Nicobranas/RoDeP-documentation/README.md

#RoDeP-documentation

The project main documentation available at: https://nicobranas.github.io/RoDeP-documentation/
