Nicobranas/RoDeP-documentation/docs/hardware_starting.md

# Building the robot

## Building order

<p align = justify>The RoDeP build can be separate in 2 parts : the frame and the gripper. The first one has most of the electronics, with the battery and the boards, the second has the gripping system, used for the elevation of the plant. Therefore, both part can be assembled simulteanously, and bind together at a later point of the project.<br/> </p>

## Building the frame

<p align = justify>As previously mentionned, the frame has most of the electronics systems of the robot. You can find the instructions in the next part.
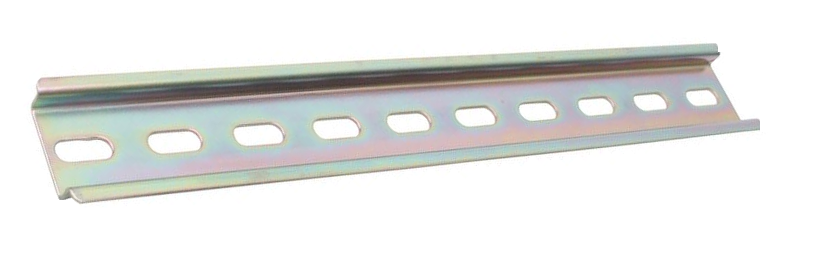
[picture p1: docs/RailDIN files/rail_DIN.png]
Rail DIN

<br/> </p>

## Building the gripper

<p align = justify>The gripper allows the RoDeP to grab the plants, elevate them in order to scan. The instructions are found after the frame.
<br/> </p>
