Nicobranas/RoDeP-documentation/docs/electriccircuit.md

## Electrical diagram

<p align = justify> Here is a diagram representing the principle of the electrical planning.</p>

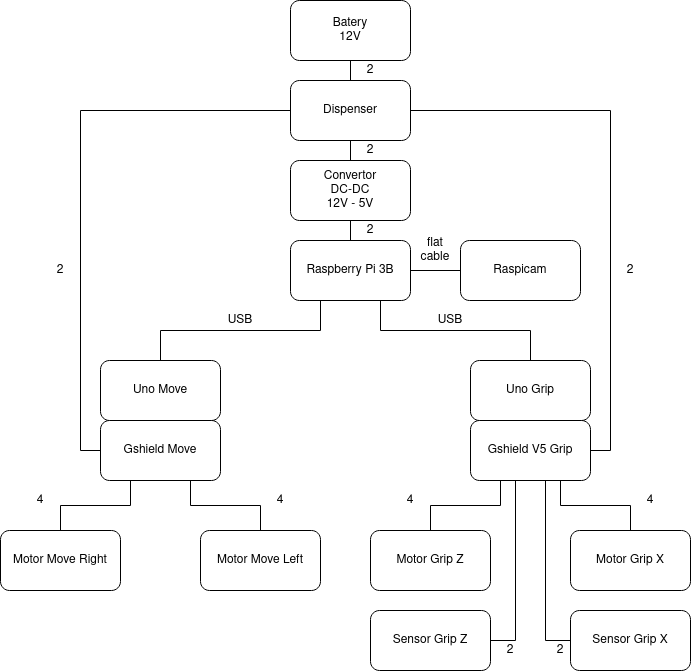
[picture p2: docs/Electronic files/electrical_diagram.png]
Electrical Diagram


## Fritzing document

<p align = justify>This Fritzing document is avaible [here](https://github.com/Nicobranas/RoDeP-documentation/tree/master/docs/Electronic%20files). On this document, we use one driver per motor, but on the real robot we have chosen to use [gShield V5](https://www.adafruit.com/product/1750), which simplify the diagram. We didn't have represent leds and camera on it, please refere to [this guide](http://www.farnell.com/datasheets/1944095.pdf)</p>

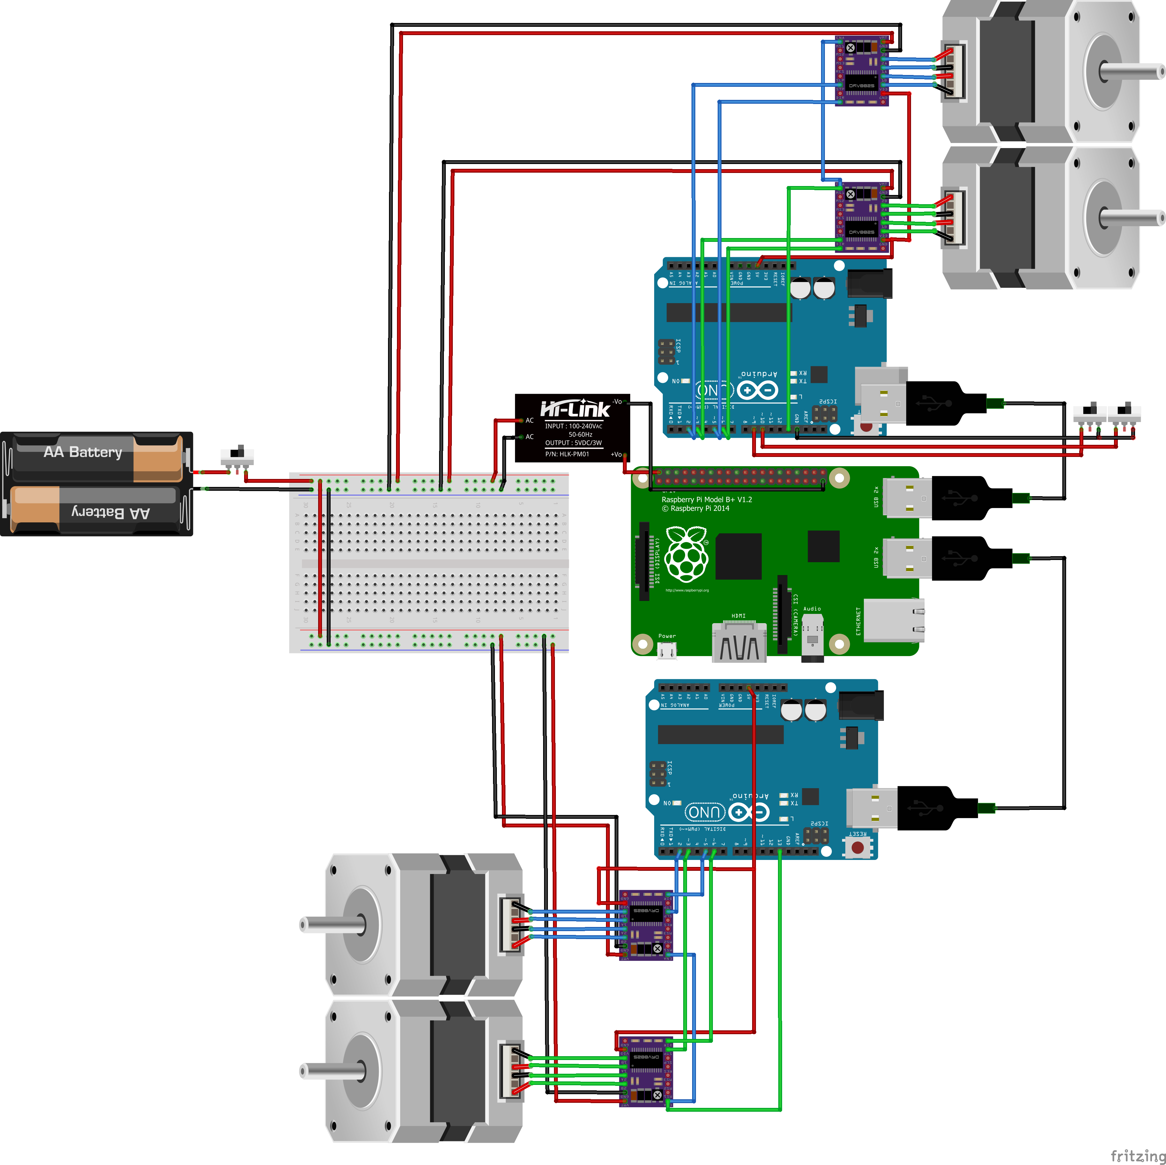
[picture p3: docs/Electronic files/RoDeP-elec.png]
Fritzing


## Steppers motors

<p align = justify>We choose steppers motors for their high accuracy. Useful for helping the line following algorithm and gripper control. Their consumption is bigger than DC motors, as they need power when not in motion, in order to hold their position.</p>
