Nicobranas/RoDeP-documentation/docs/gripp.md

#Gripper components

<p align = justify>On this page, you will find every components you need to assemble everything related to the gripper.
<br/> </p>

## The gripping part
<p align = justify>First of all, the list of the elements found on the gripping part is below :
<br/> </p>
|Number|Component|Specifications|Example|
|----|----|----|----|
|2|linear guide|||
|4|Attaches|length 25 cm||
|1|Gripper motor|Step motor|[Motor](https://www.robotshop.com/eu/fr/rbsoy07-moteur-pas-a-pas-soyo.html)|
|1|belt|length cm||
|2|cogwheel|Diameter cm, teeth||
|2|clamping jaw|||
|4|Rings|||
|4|Rings for securing the opening/closing process|||
|1|limit switch|||
|3|Screw|Reference ||
|2|binding for linear guide|||
|1|binding for worm screw|||
|14|fixing bolt|||
|4|small screw|Reference M4x12||

## Support of the gripper
<p align = justify>The components for the support part is here :
<br/> </p>
|Number|Component|Specifications|Example|
|----|----|----|----|
|4|linear guide|length : 34,5 cm, diameter 4 mm||
|1|Bottom Plate|Custom made|The plan can be found on the Git page of the project|
|1|Top plate|Custom made|The plan can be found on the Git page of the project|
|1|Gripper motor|Step motor|[Motor](https://www.robotshop.com/eu/fr/rbsoy07-moteur-pas-a-pas-soyo.html)|
|1|Worm screw|length : 40 cm, diameter cm||
|10|Clamps|Internal diameter 4 mm||
|38|M4x12 Screw|||
|4|washer|||
|2|Worm screw guide|||
|1|small cogwheel|diameter cm, teeth||
|1|big cogwheel|diameter cm, teeth||
