Nicobranas/RoDeP-documentation/docs/software_starting.md

## Software

<p align = justify> The software part of the robot has been divided in 2 : The tracking part, and the control one. Uploading the code found on Github on your Raspberry should do the trick.<br/></p>

## The tracking part
<p align = justify> The explanation of the code explaining how the RoDeP follows the line will be found here. You will find the design of the playground of the robot, the process of how the robot follows the indication marked on the ground and how the error is calculated.<br/></p>

## The control
<p align = justify> This part contains all the information you need about the control. After a brief explanation of the differents states of the machine, you can also read on how we defined the proportionnal corrector of the robot.<br/></p>
