Nicobranas/RoDeP-documentation/CAO/Support/sup_pi3_verso.jpg

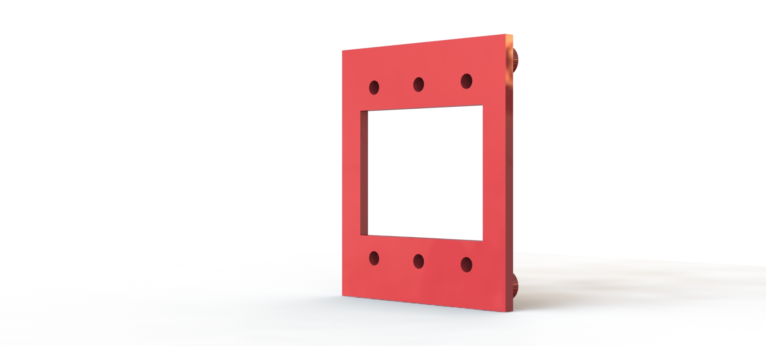
CAO/Support/sup_pi3_verso.jpg
