Nicobranas/RoDeP-documentation/CAO/Support/sup_uno_verso.jpg

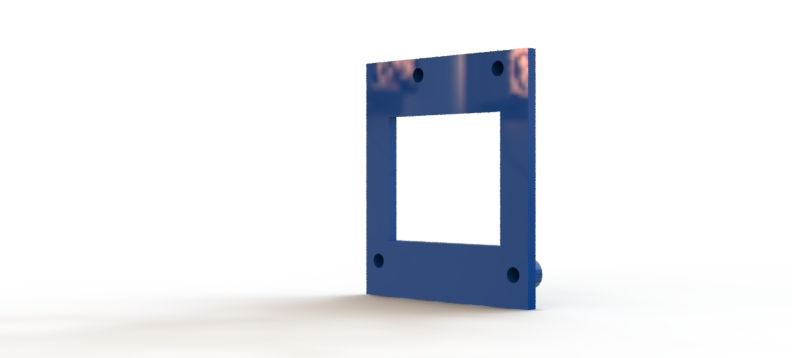
CAO/Support/sup_uno_verso.jpg
