Nicobranas/RoDeP-documentation/site/Electronic files/begin_conception.png

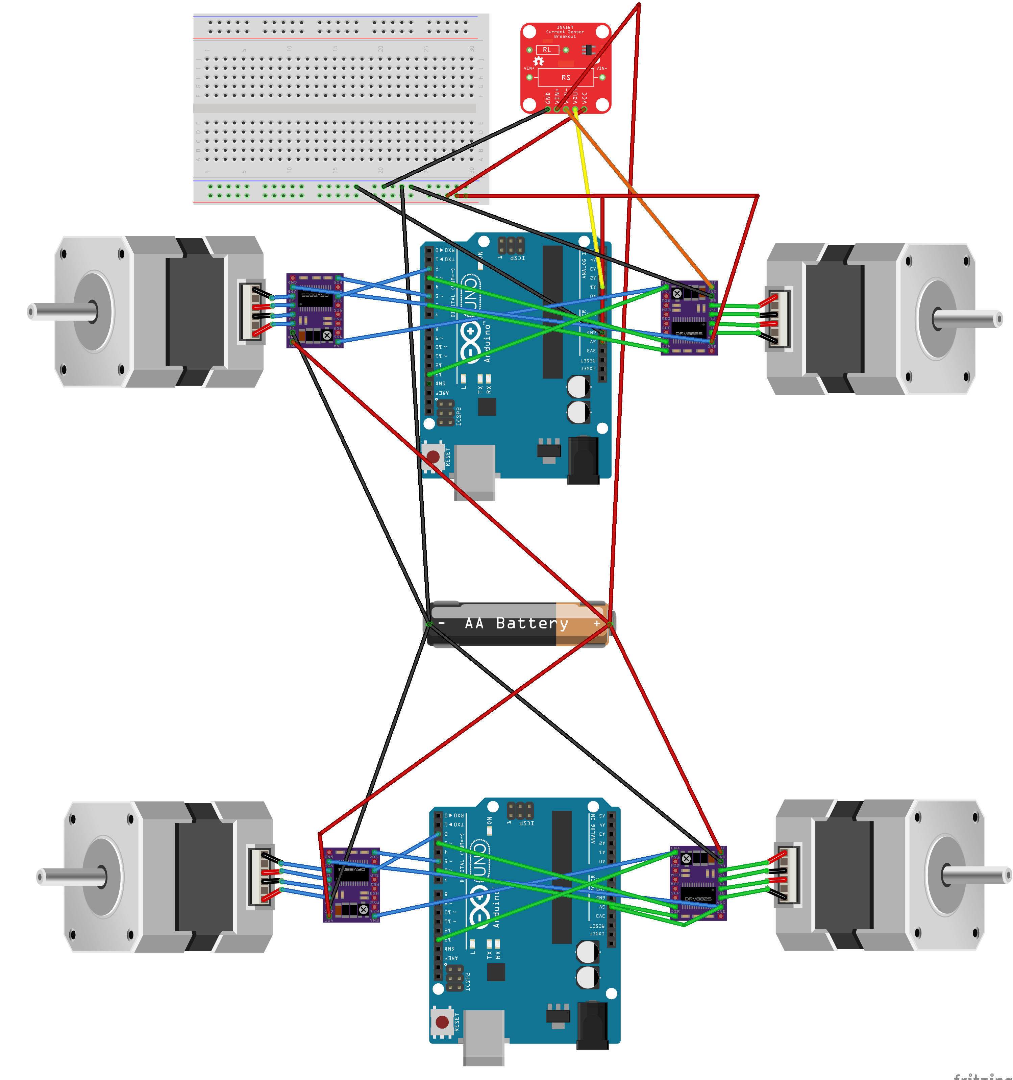
site/Electronic files/begin_conception.png
