Nicobranas/RoDeP-documentation/site/RailDIN files/pcb_support.png

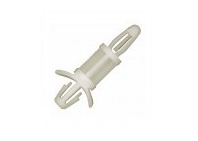
site/RailDIN files/pcb_support.png
