Nicobranas/RoDeP-documentation/site/RailDIN files/support_arduino.png

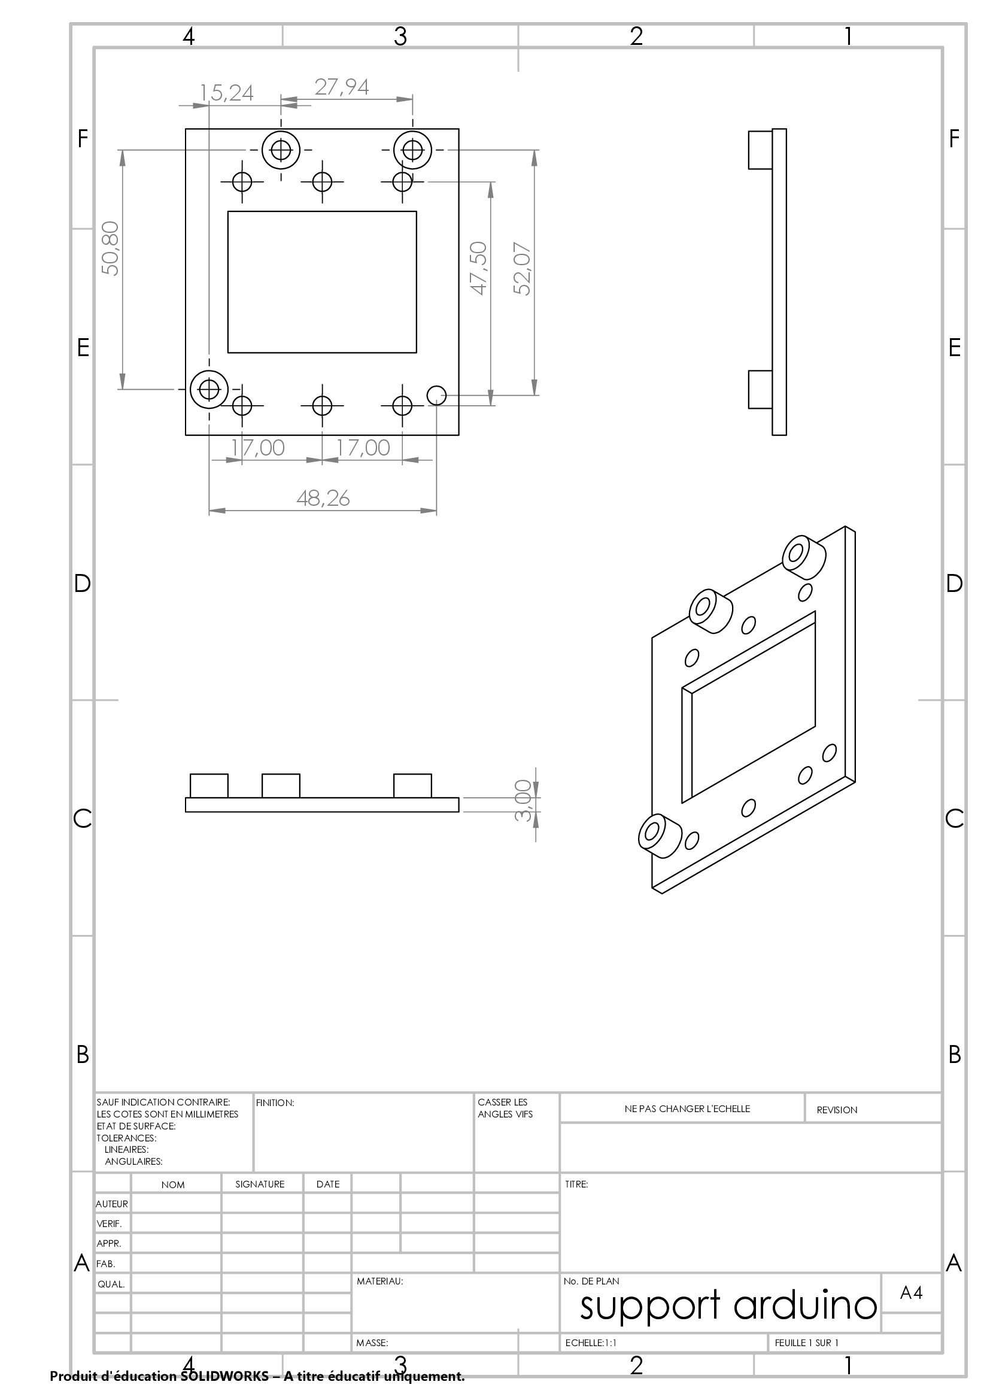
site/RailDIN files/support_arduino.png
