Nicobranas/RoDeP-documentation/site/RailDIN files/support_raspberry_3b+.png

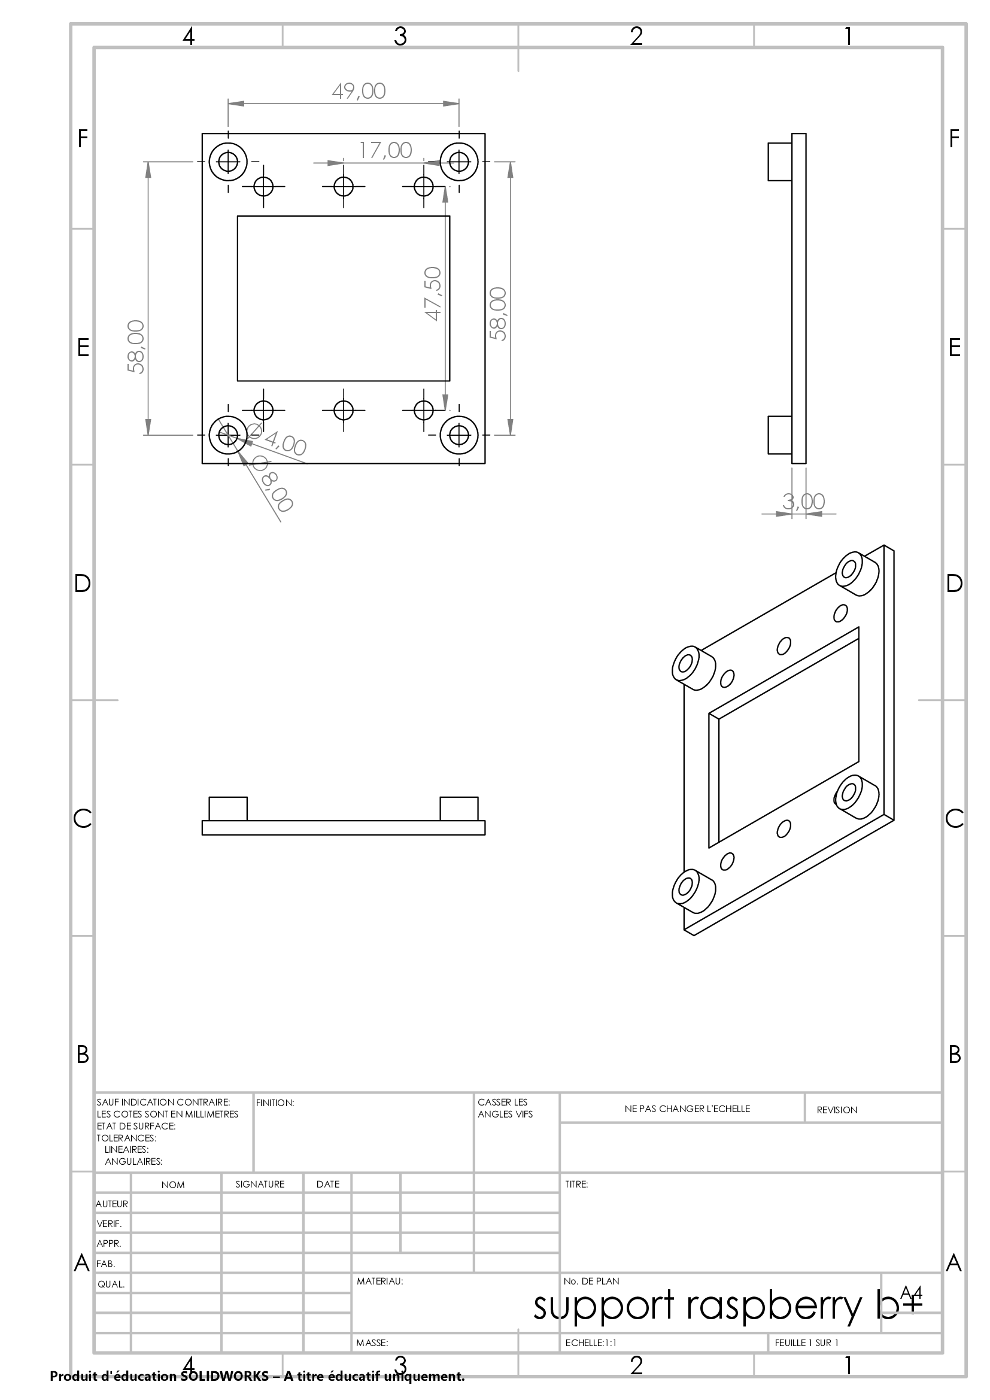
site/RailDIN files/support_raspberry_3b+.png
