Nicobranas/RoDeP-documentation/docs/component.md

# Bill Of Material

<p align = justify>This chart makes an inventory of all the elements you need to build the robot.
<br/> </p>

## Gripper components - X axis

|Number|Component|Specifications|Example|
|--- |--- |--- |--- |
|1|Plate Griper|Machining||
|1|Stepper motor|Nema 17|[Motor](https://www.robotshop.com/eu/fr/rbsoy07-moteur-pas-a-pas-soyo.html)|
|1|Pulley|||
|1|Idler gear|||
|1|Spacer|10mm for M5||
|1|Screw M5|30mm||
|1|Belt|~420mm||
|4|Shaft support upright|8mm||
|2|Shaft 8mm 250mm|||
|1|Front rail Panel|Plastic printing||
|1|Gripper arm right|Plastic printing||
|1|Gripper arm left|Plastic printing||
|2|Belt tightener|Plastic printing||
|4|Linear bearing|||
|8|Hose clamp|||
|2|Linear bearing with housing|||
|X|Screw and nuts|||

CAO for printing and machining avaible on: [link](https://github.com/Nicobranas/RoDeP-documentation/tree/master/CAO/X_V2-axis)

## Gripper components - Z axis

|Number|Component|Specifications|Example|
|--- |--- |--- |--- |
|1|Plate top|Machining||
|1|Plate bottom|Machining||
|1|Stepper motor|Nema 17|[Motor](https://www.robotshop.com/eu/fr/rbsoy07-moteur-pas-a-pas-soyo.html)|
|1|Pulley|||
|1|Idler gear|||
|1|Belt|<600mm||
|1|Belt clamp|Plastic printing||
|1|2GT_timer|||
|2|Shaft support upright|8mm||
|4|Shaft support flat|8mm||
|2|Shaft|30mm||
|2|Shaft|15mm||
|1|Braket|Plastic printing||
|X|Screw and nuts|||

CAO for printing and machining avaible on: [link](https://github.com/Nicobranas/RoDeP-documentation/tree/master/CAO/Z_V2-axis)

## Rover components

|Number|Component|Specifications|Example|
|--- |--- |--- |--- |
|1|Frame|Machining||
|2|Wheel motor|Step motor|[Motor](https://french.alibaba.com/product-detail/nema-23-stepper-motor-0-9degree--1036063772.html)|
||Encodeurs????|||
|2|Stepper Mounting Bracket||[NEMA 23](https://www.phidgets.com/?tier=3&catid=24&pcid=21&prodid=358)|
|2|Wheel|||
|2|Screw hub|||
|2|Roulette|||
|2|Battery wedge|||
|1|Camera Box|Plastic printing (in two parts)||
|2|Shaft support flat|8 mm||
|[12;30]|Inserts|M2.5|[Inserts](https://www.amazon.fr/dp/B088QJDPKK/ref=twister_B07YZQ5T3Z?_encoding=UTF8&psc=1)|
|X|Screw and nuts|||

CAO for printing and machining avaible on: [link](https://github.com/Nicobranas/RoDeP-documentation/tree/master/CAO/ungrip_rover)

## Electrical components and RailDin

|Number|Component|Specifications|Example|
|--- |--- |--- |--- |
|1|Battery|LIFEPO4 <br/> 12V <br/> BMS Protection|[Power Battery](https://www.power-manutention.fr/batteries-decharge-lente/batterie-lithium-fer-phosphate-lifepo4-12v-12ah-power-battery-9423.html)|
|1|Charger||[NOCO GENIUS2](https://no.co/genius2)|
|1|Voltage converter|12V - 5V <br/> Rail Din adapted|[Voltage converter](https://fr.rs-online.com/web/p/alimentations-rail-din/1757801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)|
|1|Switch||[Switch](https://fr.rs-online.com/web/p/interrupteurs-a-bascule/7182247p/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)|
|1|Singel board computeur|Raspberry Pi 4|[Raspberry Pi 4](https://www.raspberrypi.org/products/raspberry-pi-4-model-b/)|
|1|Camera||[Raspicam](https://www.conrad.fr/p/camera-raspberry-pi-913-2664-1-pcs-1438999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)|
|1|LED|Raspicam adapted LED|[LED lisiparoi](https://fr.farnell.com/cyntech/lisiparoiwht-01/lisiparoi-white-led-camera-light/dp/2840710)|
|2|Controlleur|Arduino uno or equivalent|[Arduino Uno](https://www.gotronic.fr/art-carte-arduino-uno-12420.htm)|
|2|Motor driver|Shield for Arduino|[gShield V5](https://www.adafruit.com/product/1750)|
|2|Limit switch||[Limit switch](https://fr.rs-online.com/web/p/interrupteurs-de-fin-de-course/3860423/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)|
|1|Rail DIN||[Rail DIN](https://fr.rs-online.com/web/p/rails-din/8039514/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)|
|3|Rail DIN fixation||[Rail DIN fixation](https://www.amazon.fr/Oumefar-Montage-Fixation-Support-Semi-conducteurs/dp/B08PL3G7JG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)|
|2|Arduino fixation|Plastic printing|[link](https://github.com/Nicobranas/RoDeP-documentation/tree/master/CAO/Support)|
|1|Raspberry fixation|Plastic printing|[link](https://github.com/Nicobranas/RoDeP-documentation/tree/master/CAO/Support)|
|2|Connector strip|5-pole|[Wago](https://fr.rs-online.com/web/p/borniers-de-raccordement/5077011/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,bornier+de+raccordement+(2)-_-5077011&matchtype=&pla-383168632703&gclid=EAIaIQobChMIz5PziIPR8AIVmfhRCh0g8lEAQYByABEgI4zfD_BwE&gclsrc=aw.ds)|
|2|Rail DIN's fixation for wago||[Fixation for wago](https://fr.farnell.com/wago/222-500/montage-conn-splicing-orange/dp/2643509)|
|X|Wires|||
|X|Screw and nuts|||

CAO for printing and machining avaible on: [link](https://github.com/Nicobranas/RoDeP-documentation/tree/master/CAO/Support)
