Nicobranas/RoDeP-documentation/CAO/belt_system_V2.STEP

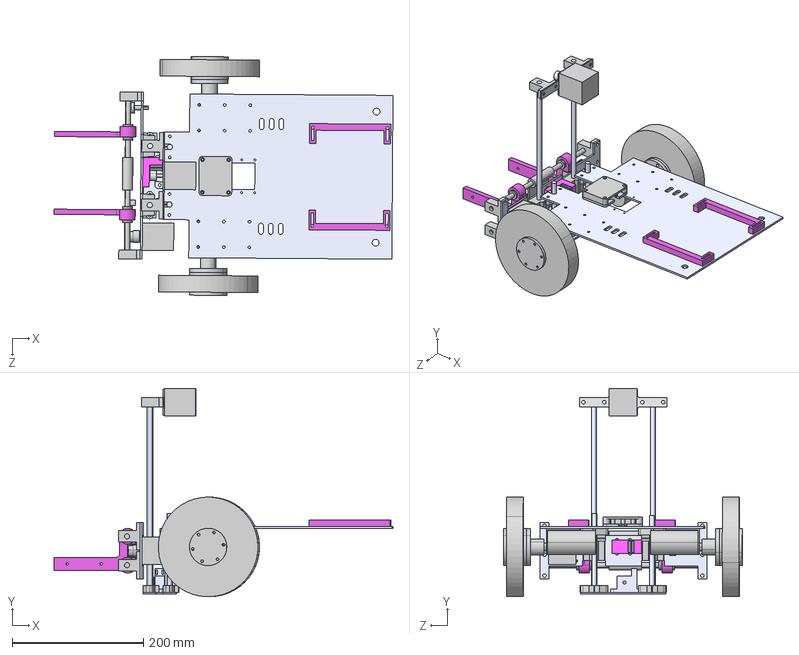
[picture p22: CAD file, 2021-07-28]
CAO/belt_system_V2.STEP
517.3 x 317.9 x 364.6 mm
Screw Hub x 2
Motor Pololu 131_1 x 2
Motor Bracket x 2
Wheel x 2
Frame
Camera Box Bottom
Camera Box Top
support batterie x 2
Shaft Support 8 mm flat x 6
Plaque_dessus_profil
radial ball bearing_68_iso_ISO 15 RBB - 325 - 8,SI,NC,8_68
hex nut gradec_iso_ISO - 4034 - M5 - N
angular contact ball bearing_68_iso_ISO 15 ABB - 496 - 10,SI,NC,10_68
pince_courroie
Shaft support 8mm upright x 6
Shaft 8 mm 250 mm x 2
Stepper Nema 17 x 2
Spacer 10 mm for screw 5 mm
Linear Bearing 8 mm x 4
Screw M5 30 mm
Linear Bearing with Housing 8 mm shaft x 2
Pulley GT2 20 teeth 5 mm bore 6 mm belt
Idler
Front Rail Panel
Gripper arm left
Gripper arm right
Belt Tightner x 2
Plate Gripper
2GT_timer x 2
Plate_Z_bottom_V2
Shaft 8 mm 300 mm x 2
Shaft 8 mm 150 mm x 2
equerre3
