Nicobranas/RoDeP-documentation/CAO/Support/support raspberry 3b+.STEP

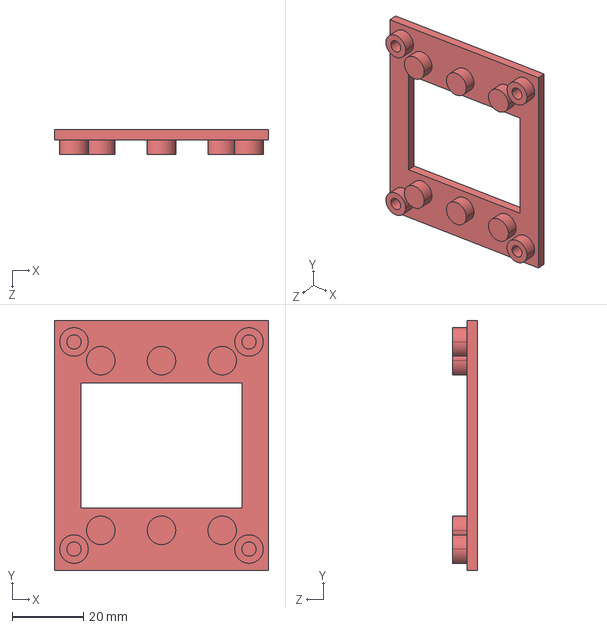
[picture p23: CAD file, 2021-07-29]
CAO/Support/support raspberry 3b+.STEP
60.0 x 70.0 x 7.00 mm
