Nicobranas/RoDeP-documentation/CAO/ungrip_rover/support batterie.STEP

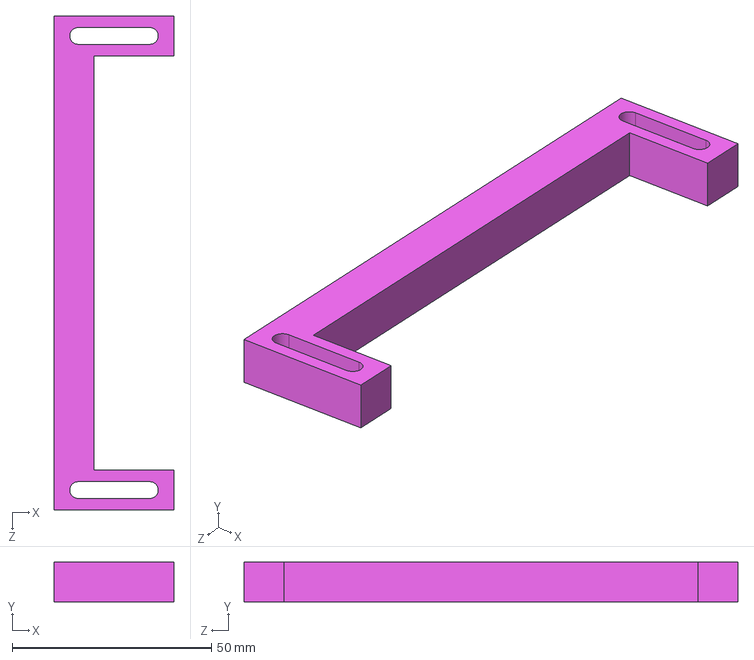
[picture p24: CAD file, 2021-07-28]
CAO/ungrip_rover/support batterie.STEP
30.0 x 10.0 x 124.0 mm
