Nicobranas/RoDeP-documentation/CAO/X_V2-axis/Belt Tightner.STEP

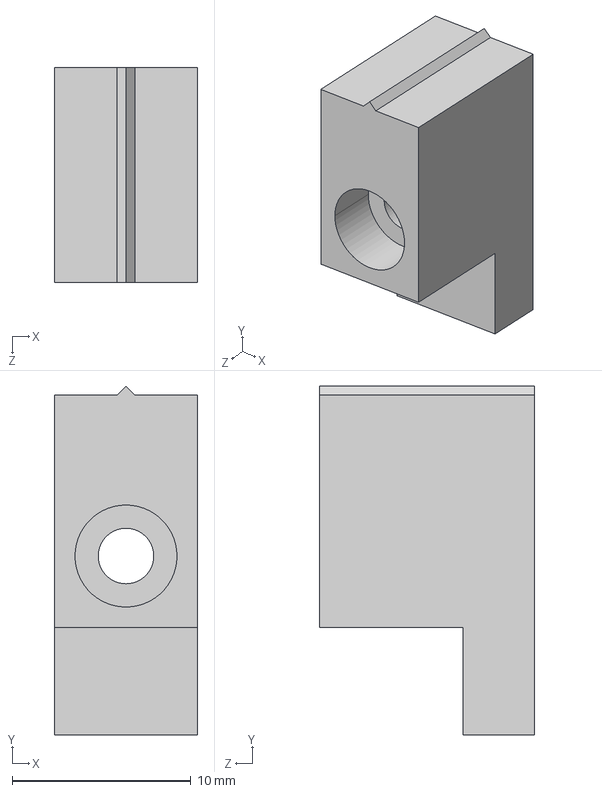
[picture p25: CAD file, 2021-07-28]
CAO/X_V2-axis/Belt Tightner.STEP
8.00 x 19.5 x 12.0 mm
