Nicobranas/RoDeP-documentation/CAO/Z_V2-axis/belt clamp.STEP

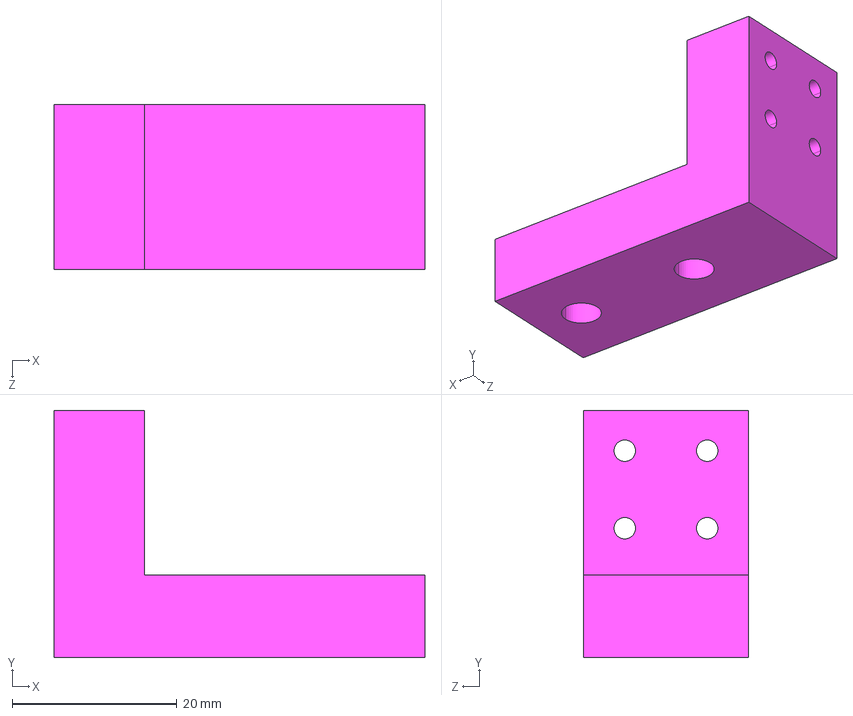
[picture p26: CAD file, 2021-07-29]
CAO/Z_V2-axis/belt clamp.STEP
45.0 x 30.0 x 20.0 mm
