Nicobranas/RoDeP-documentation/CAO/Support/support arduino uno.STEP

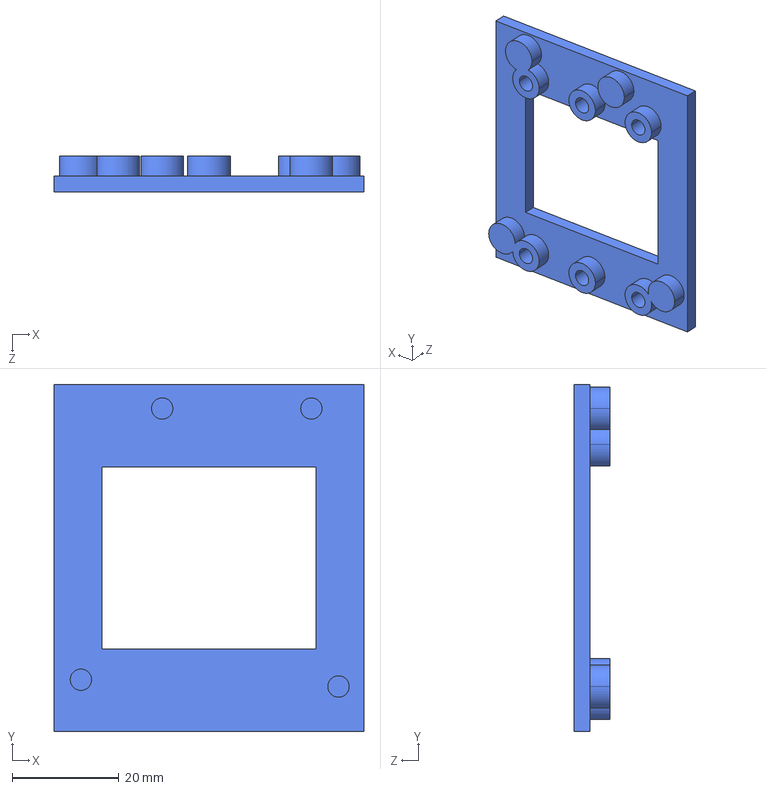
[picture p27: CAD file, 2021-07-29]
CAO/Support/support arduino uno.STEP
58.0 x 65.0 x 6.70 mm
