Nicobranas/RoDeP-documentation/CAO/ungrip_rover/Camera Box Top.STEP

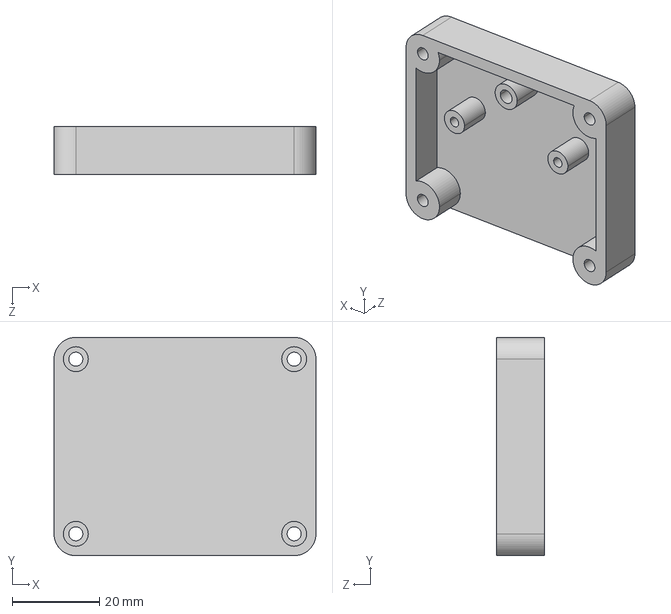
[picture p28: CAD file, 2021-07-28]
CAO/ungrip_rover/Camera Box Top.STEP
60.0 x 50.0 x 11.0 mm
