Nicobranas/RoDeP-documentation/CAO/X_V2-axis/Front Rail Panel.STEP

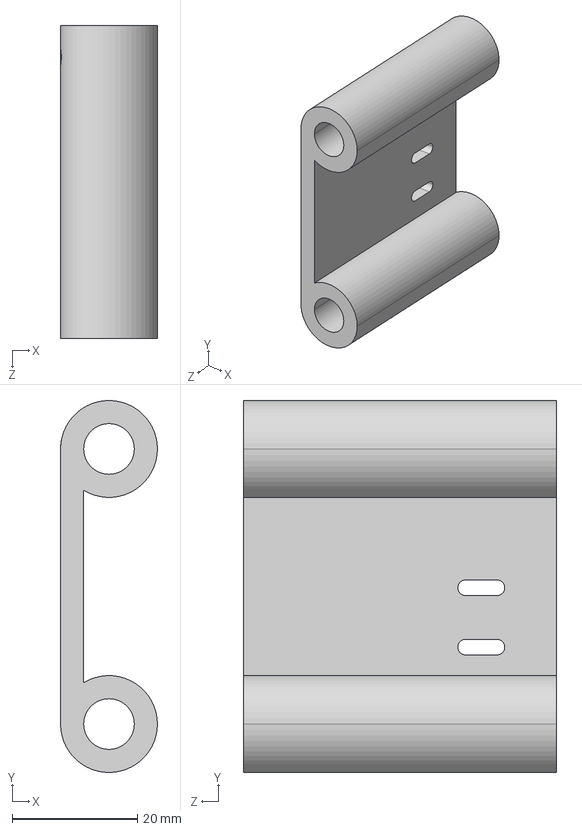
[picture p29: CAD file, 2021-07-28]
CAO/X_V2-axis/Front Rail Panel.STEP
15.5 x 59.5 x 50.0 mm
