Nicobranas/RoDeP-documentation/CAO/Z_V2-axis/Stepper Nema 17.STEP

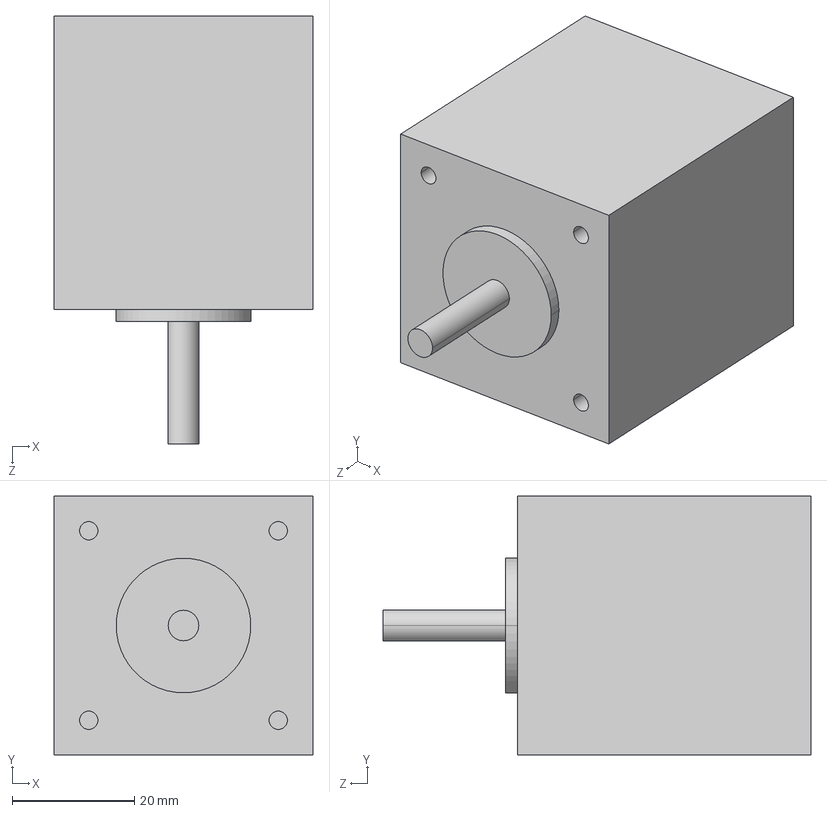
[picture p30: CAD file, 2021-07-28]
CAO/Z_V2-axis/Stepper Nema 17.STEP
42.3 x 42.3 x 70.0 mm
