Nicobranas/RoDeP-documentation/CAO/ungrip_rover/Wheel.STEP

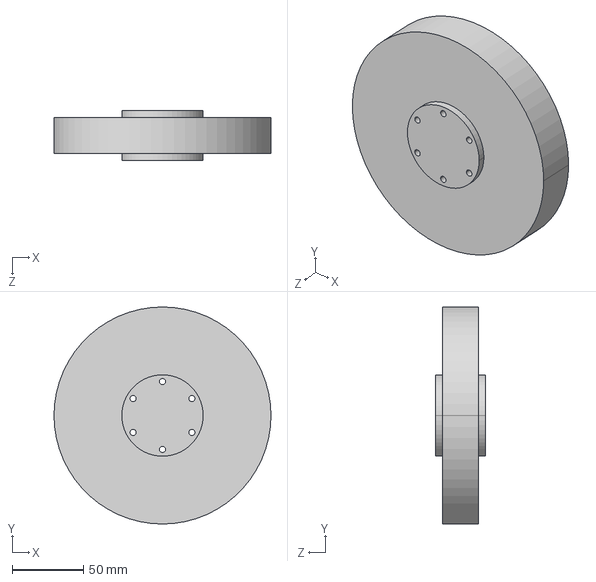
[picture p31: CAD file, 2021-07-28]
CAO/ungrip_rover/Wheel.STEP
152.0 x 152.0 x 34.9 mm
