Nicobranas/RoDeP-documentation/CAO/Z_V2-axis/Bracket.STEP

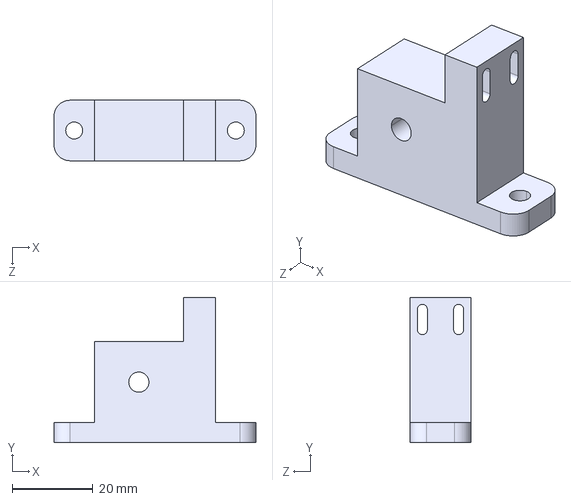
[picture p32: CAD file, 2021-07-28]
CAO/Z_V2-axis/Bracket.STEP
50.0 x 36.0 x 15.0 mm
