Nicobranas/RoDeP-documentation/CAO/ungrip_rover/Motor Bracket.STEP

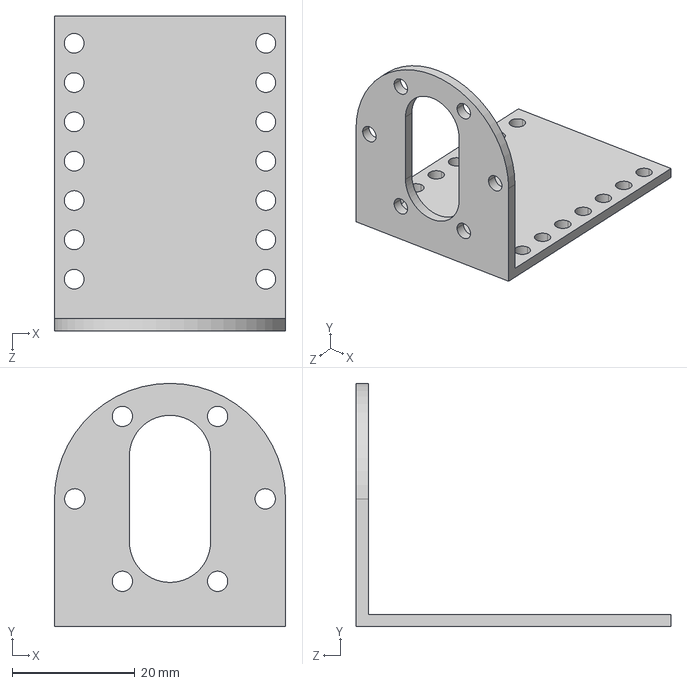
[picture p33: CAD file, 2021-07-28]
CAO/ungrip_rover/Motor Bracket.STEP
37.6 x 39.6 x 51.2 mm
