Nicobranas/RoDeP-documentation/CAO/X_V2-axis/Plate Gripper.STEP

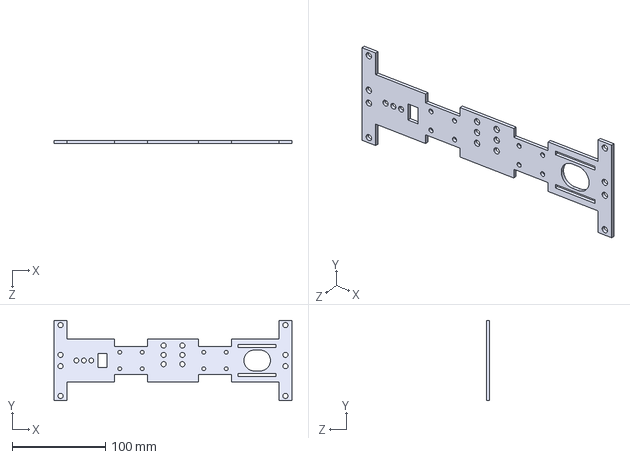
[picture p34: CAD file, 2021-07-28]
CAO/X_V2-axis/Plate Gripper.STEP
255.0 x 86.0 x 3.00 mm
