Nicobranas/RoDeP-documentation/CAO/Z_V2-axis/Plate_Z_top_V2.STEP

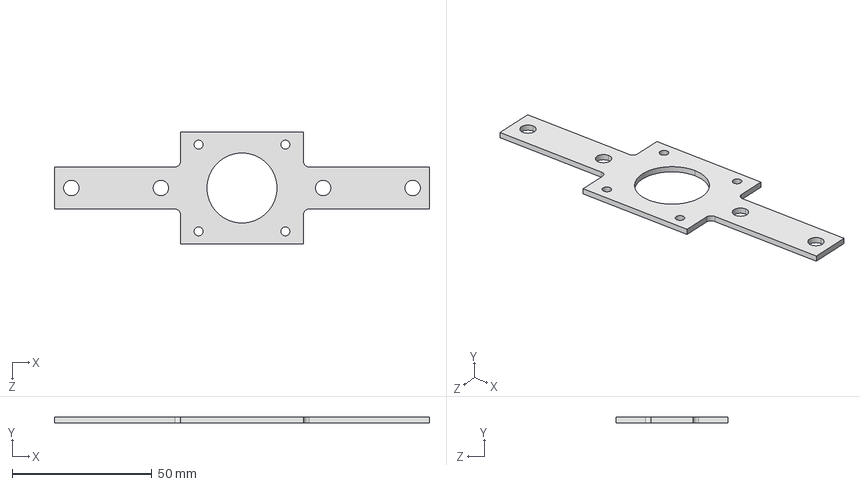
[picture p35: CAD file, 2021-07-28]
CAO/Z_V2-axis/Plate_Z_top_V2.STEP
134.0 x 2.00 x 40.0 mm
