Nicobranas/RoDeP-documentation/CAO/ungrip_rover/Camera Box Bottom.STEP

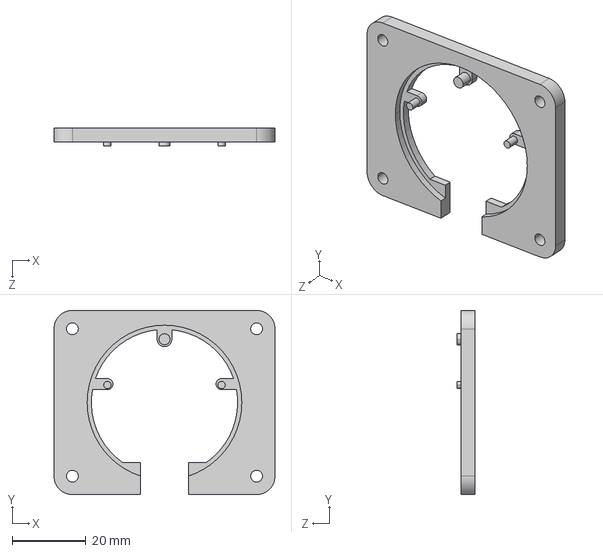
[picture p36: CAD file, 2021-07-28]
CAO/ungrip_rover/Camera Box Bottom.STEP
60.0 x 50.0 x 5.00 mm
