Nicobranas/RoDeP-documentation/CAO/X_V2-axis/Pulley GT2 20 teeth 5 mm bore 6 mm belt.STEP

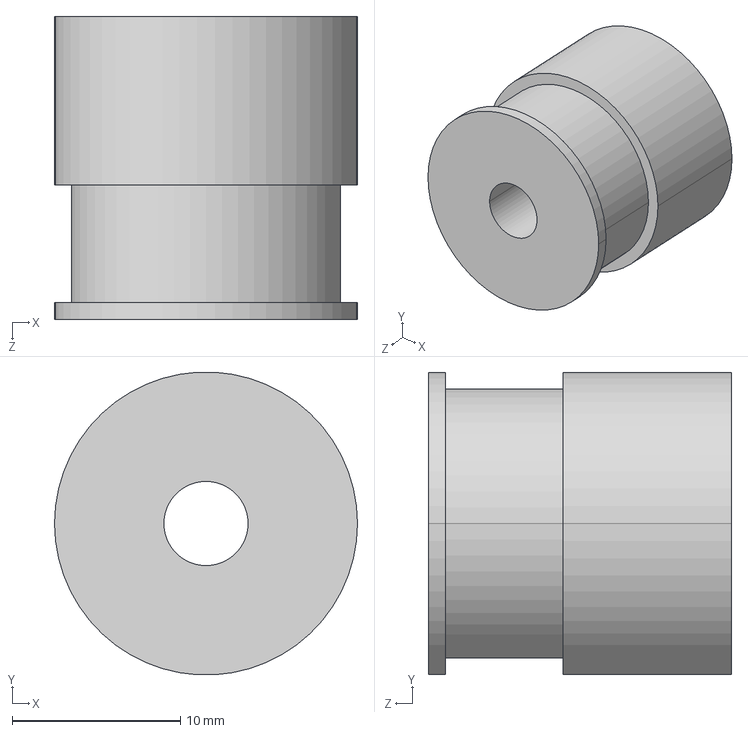
[picture p37: CAD file, 2021-07-28]
CAO/X_V2-axis/Pulley GT2 20 teeth 5 mm bore 6 mm belt.STEP
18.0 x 18.0 x 18.0 mm
