Nicobranas/RoDeP-documentation/CAO/Z_V2-axis/Shaft 8 mm 300 mm.STEP

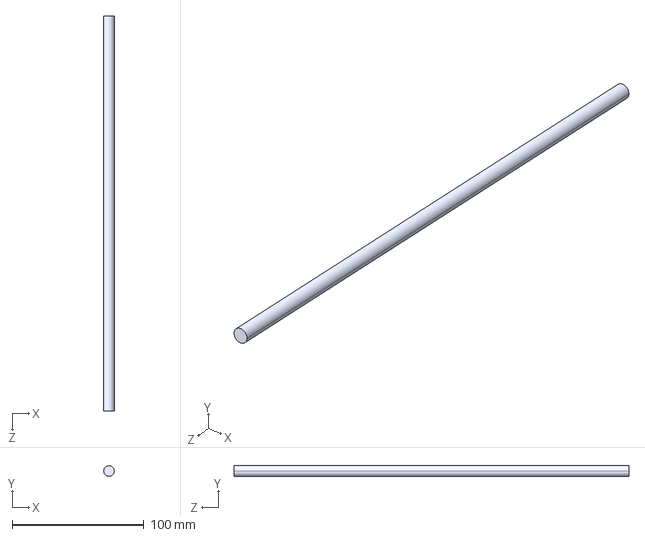
[picture p38: CAD file, 2021-07-28]
CAO/Z_V2-axis/Shaft 8 mm 300 mm.STEP
8.00 x 8.00 x 300.0 mm
