Nicobranas/RoDeP-documentation/CAO/ungrip_rover/Motor Pololu 131_1.STEP

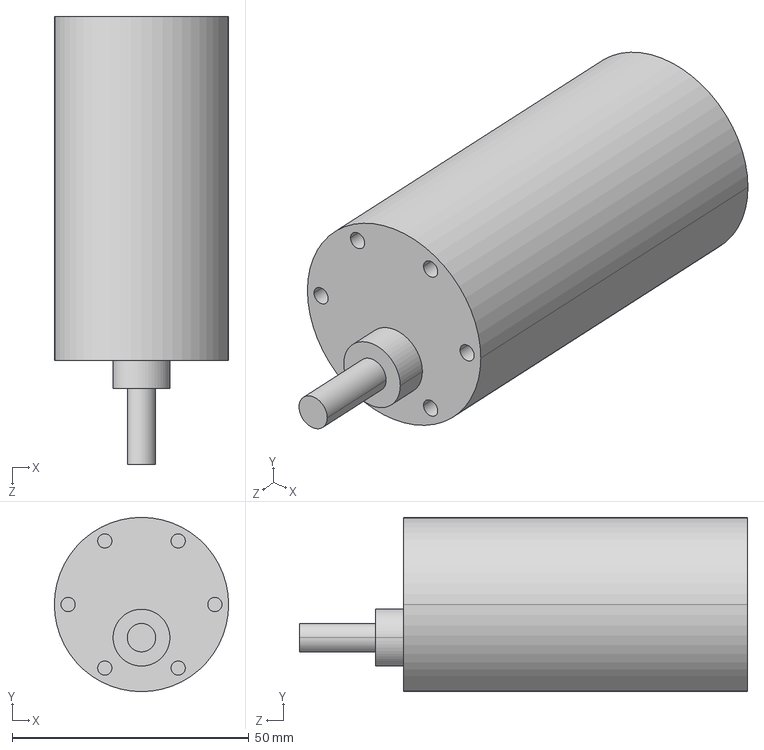
[picture p39: CAD file, 2021-07-28]
CAO/ungrip_rover/Motor Pololu 131_1.STEP
36.8 x 36.8 x 94.6 mm
