Nicobranas/RoDeP-documentation/CAO/X_V2-axis/Shaft 8 mm 250 mm.STEP

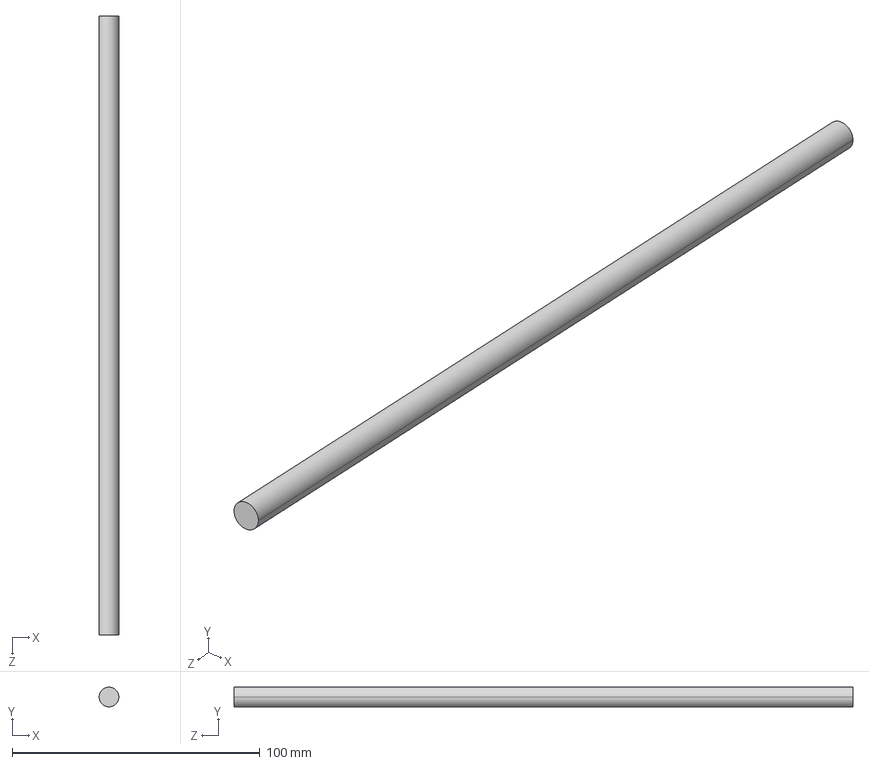
[picture p40: CAD file, 2021-07-28]
CAO/X_V2-axis/Shaft 8 mm 250 mm.STEP
8.00 x 8.00 x 250.0 mm
