Nicobranas/RoDeP-documentation/CAO/X_V2-axis/Linear Bearing with Housing 8 mm shaft.STEP

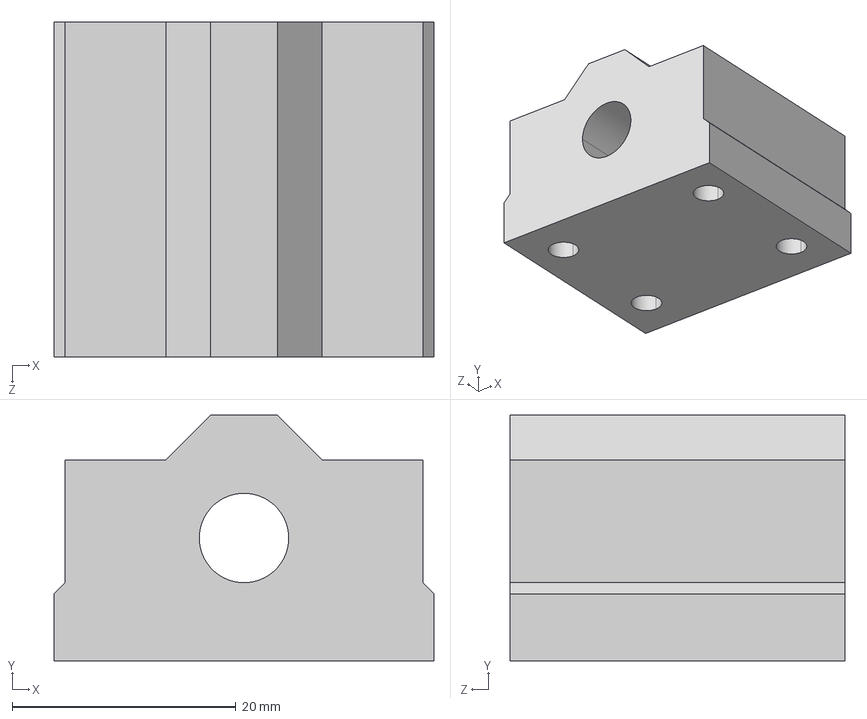
[picture p42: CAD file, 2021-07-28]
CAO/X_V2-axis/Linear Bearing with Housing 8 mm shaft.STEP
34.0 x 22.0 x 30.0 mm
