Nicobranas/RoDeP-documentation/CAO/Z_V2-axis/Plate_Z_bottom_V2.STEP

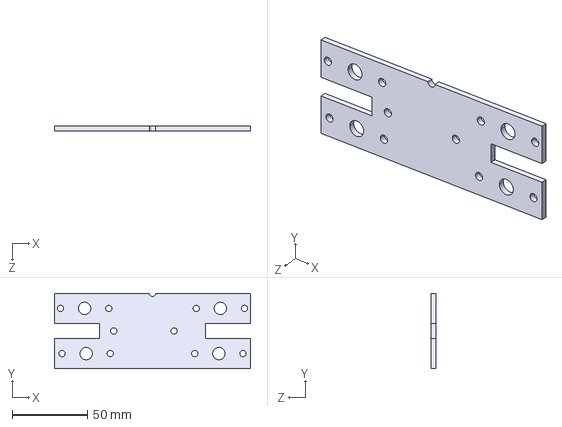
[picture p43: CAD file, 2021-07-28]
CAO/Z_V2-axis/Plate_Z_bottom_V2.STEP
130.0 x 50.0 x 3.00 mm
