Nicobranas/RoDeP-documentation/CAO/ungrip_rover/ungrip_rover.STEP

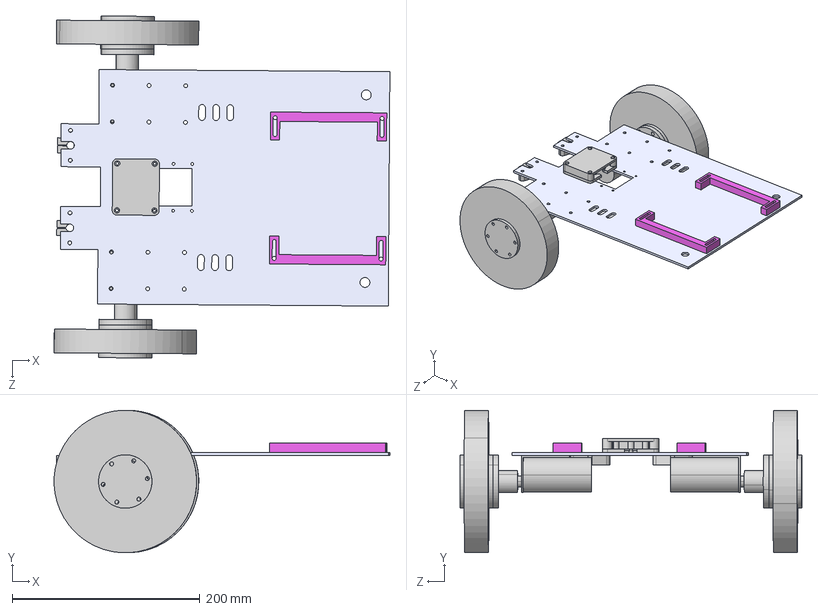
[picture p44: CAD file, 2021-07-28]
CAO/ungrip_rover/ungrip_rover.STEP
358.0 x 151.8 x 364.6 mm
Screw Hub x 2
Motor Pololu 131_1 x 2
Motor Bracket x 2
Wheel x 2
Frame
Camera Box Bottom
Camera Box Top
support batterie x 2
Shaft Support 8 mm flat x 2
