Nicobranas/RoDeP-documentation/CAO/X_V2-axis/Gripper arm right.STEP

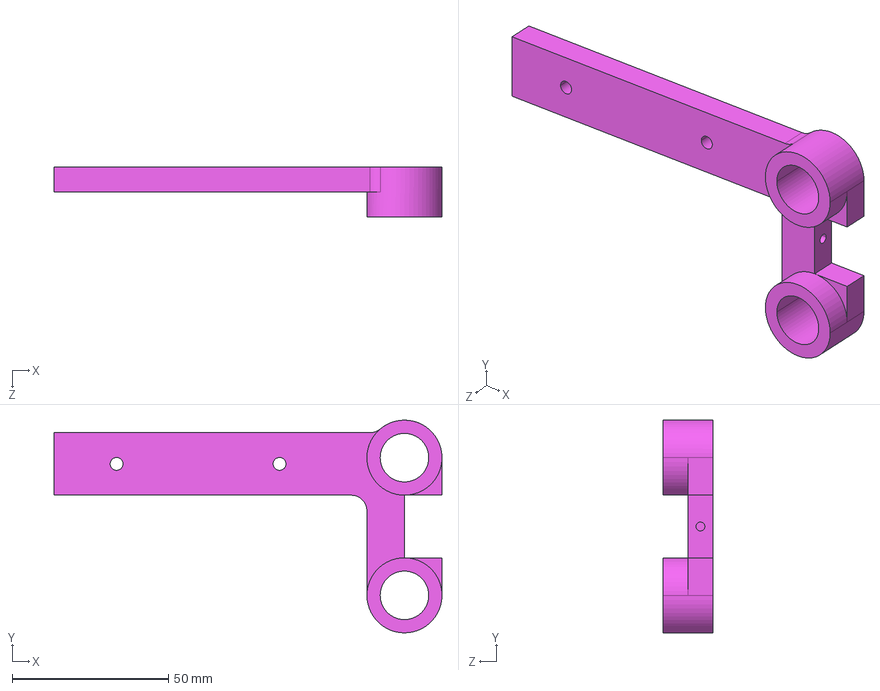
[picture p45: CAD file, 2021-07-28]
CAO/X_V2-axis/Gripper arm right.STEP
124.0 x 68.0 x 16.0 mm
