Nicobranas/RoDeP-documentation/CAO/Z_V2-axis/2GT_timer.STEP

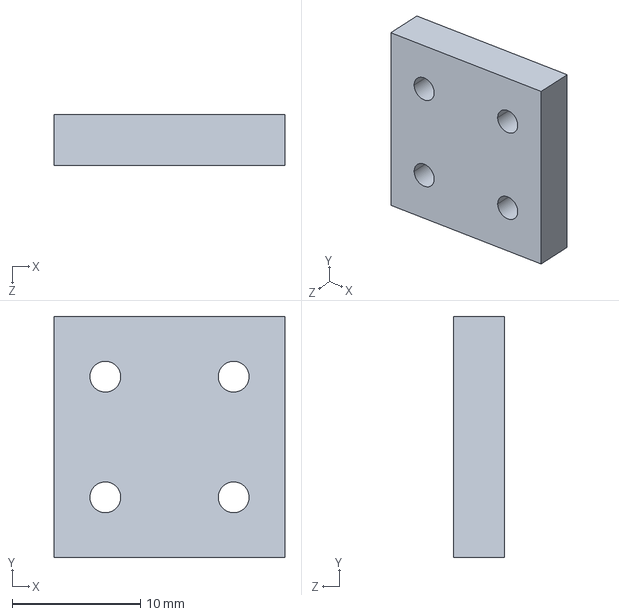
[picture p46: CAD file, 2021-07-28]
CAO/Z_V2-axis/2GT_timer.STEP
18.0 x 18.8 x 4.00 mm
