Nicobranas/RoDeP-documentation/CAO/ungrip_rover/Frame.STEP

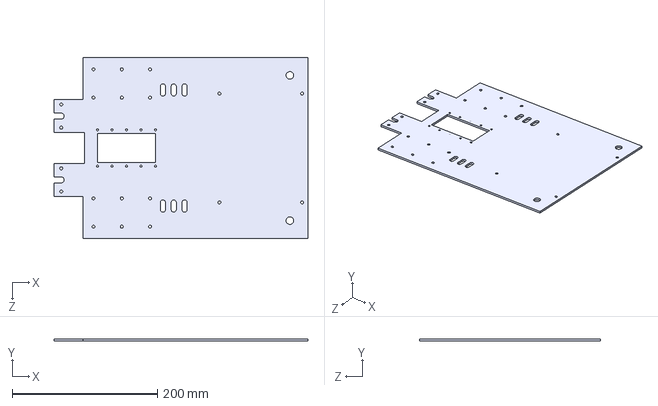
[picture p47: CAD file, 2021-07-28]
CAO/ungrip_rover/Frame.STEP
350.0 x 3.00 x 250.0 mm
