Nicobranas/RoDeP-documentation/CAO/X_V2-axis/Shaft support 8mm upright.STEP

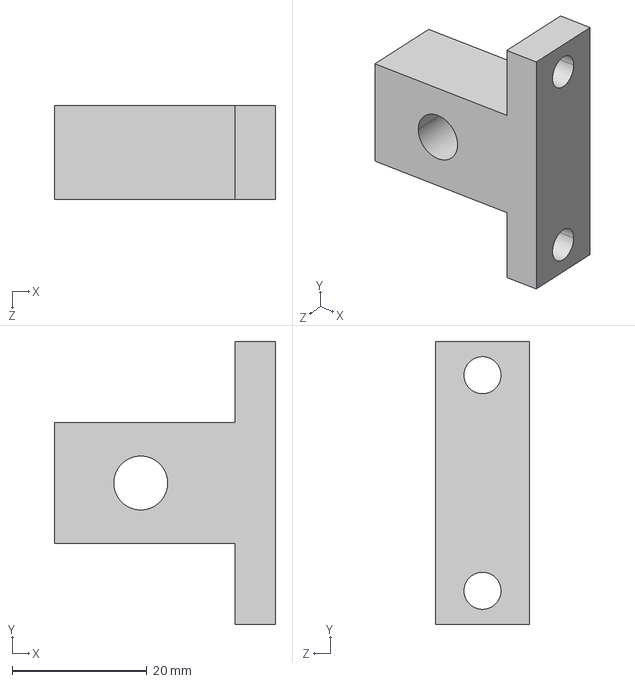
[picture p48: CAD file, 2021-07-28]
CAO/X_V2-axis/Shaft support 8mm upright.STEP
32.8 x 42.0 x 14.0 mm
