Nicobranas/RoDeP-documentation/CAO/ungrip_rover/Shaft Support 8 mm flat.STEP

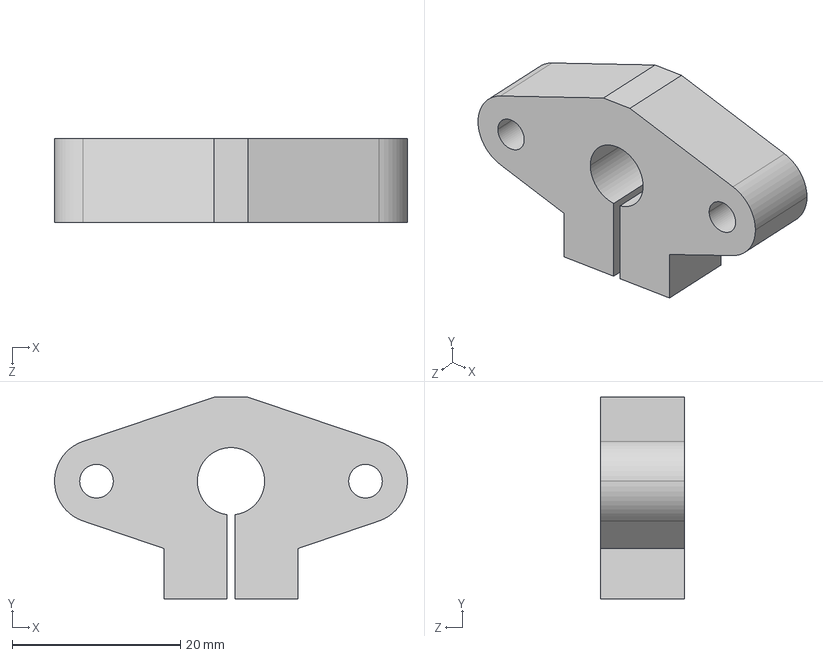
[picture p50: CAD file, 2021-07-28]
CAO/ungrip_rover/Shaft Support 8 mm flat.STEP
42.0 x 24.0 x 10.0 mm
