Nicobranas/RoDeP-documentation/CAO/X_V2-axis/Idler.STEP

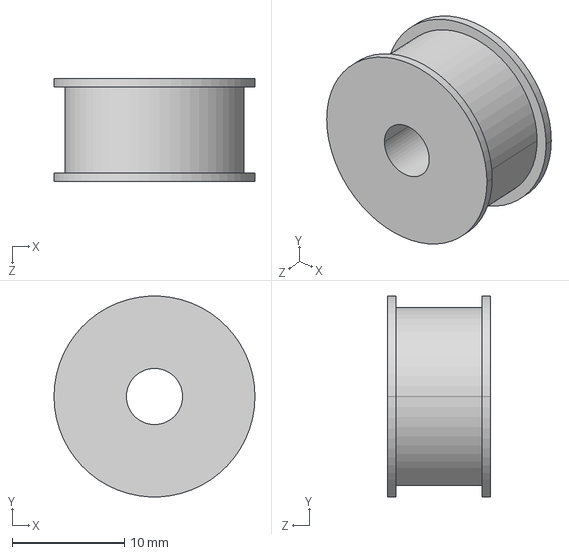
[picture p51: CAD file, 2021-07-28]
CAO/X_V2-axis/Idler.STEP
17.9 x 17.9 x 9.20 mm
