Nicobranas/RoDeP-documentation/CAO/X_V2-axis/Linear Bearing 8 mm.STEP

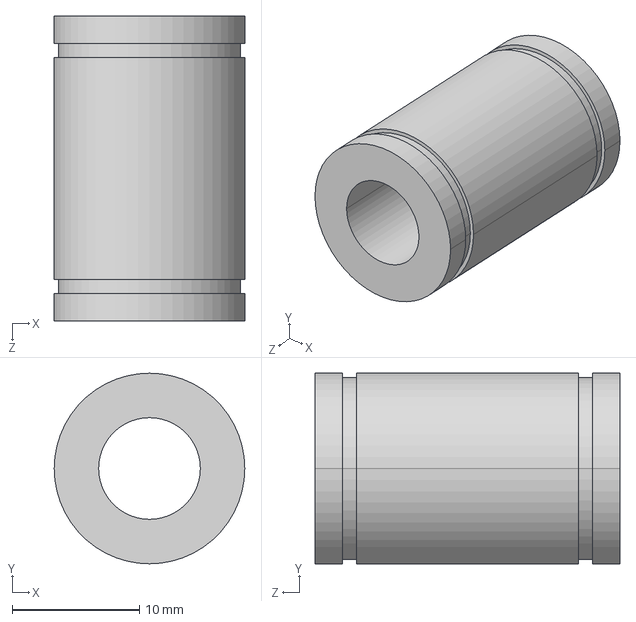
[picture p52: CAD file, 2021-07-28]
CAO/X_V2-axis/Linear Bearing 8 mm.STEP
15.0 x 15.0 x 24.0 mm
