Nicobranas/RoDeP-documentation/CAO/X_V2-axis/X-axis.STEP

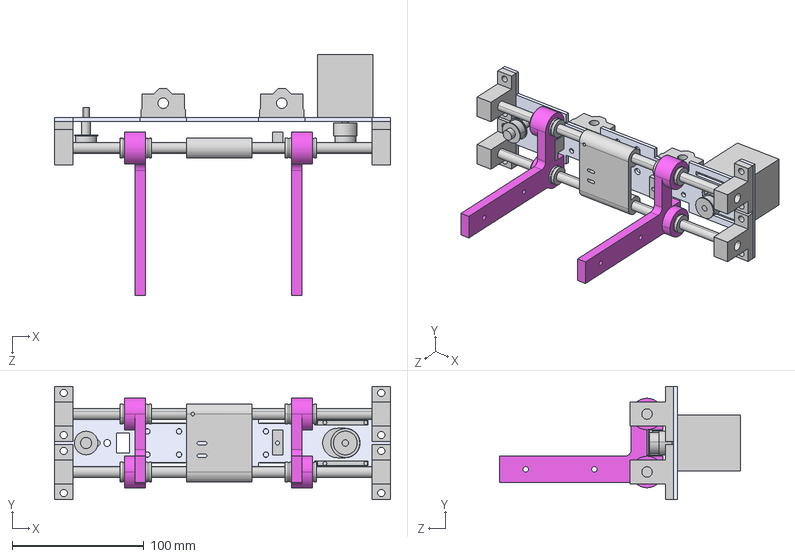
[picture p53: CAD file, 2021-07-28]
CAO/X_V2-axis/X-axis.STEP
255.0 x 86.0 x 183.0 mm
Shaft support 8mm upright x 4
Shaft 8 mm 250 mm x 2
Stepper Nema 17
Spacer 10 mm for screw 5 mm
Linear Bearing 8 mm x 4
Screw M5 30 mm
Linear Bearing with Housing 8 mm shaft x 2
Pulley GT2 20 teeth 5 mm bore 6 mm belt
Idler
Front Rail Panel
Gripper arm left
Gripper arm right
Belt Tightner x 2
Plate Gripper
