Nicobranas/RoDeP-documentation/(list of files, cad)

Other CAD files:
CAO/X_V2-axis/Stepper Nema 17.STEP
CAO/X_V2-axis/Gripper arm left.STEP
CAO/Support/support arduino uno.SLDPRT
CAO/Support/support arduino uno.STL
CAO/Support/support raspberry 3b+.SLDPRT
CAO/Support/support raspberry 3b+.STL
CAO/X_V2-axis/Belt Tightner.sldprt
CAO/X_V2-axis/Belt Tightner.stl
CAO/X_V2-axis/Front Rail Panel.sldprt
CAO/X_V2-axis/Front Rail Panel.stl
CAO/X_V2-axis/Gripper arm left.SLDPRT
CAO/X_V2-axis/Gripper arm left.STL
CAO/X_V2-axis/Gripper arm right.SLDPRT
CAO/X_V2-axis/Gripper arm right.STL
CAO/X_V2-axis/Idler.sldprt
CAO/X_V2-axis/Linear Bearing 8 mm.sldprt
CAO/X_V2-axis/Linear Bearing with Housing 8 mm shaft.sldprt
CAO/X_V2-axis/Plate Gripper.SLDPRT
CAO/X_V2-axis/Pulley GT2 20 teeth 5 mm bore 6 mm belt.sldprt
CAO/X_V2-axis/Screw M5 30 mm.STEP
CAO/X_V2-axis/Screw M5 30 mm.sldprt
CAO/X_V2-axis/Shaft 8 mm 250 mm.sldprt
CAO/X_V2-axis/Shaft support 8mm upright.sldprt
CAO/X_V2-axis/Spacer 10 mm for screw 5 mm.STEP
CAO/X_V2-axis/Spacer 10 mm for screw 5 mm.sldprt
CAO/X_V2-axis/Stepper Nema 17.sldprt
CAO/X_V2-axis/X-axis.sldasm
CAO/X_V2-axis/archives/Leadscrew Nut Anti-backslash.STEP
CAO/X_V2-axis/archives/Leadscrew Nut Anti-backslash.sldprt
CAO/X_V2-axis/archives/Omron SS-5GL2.STEP
CAO/X_V2-axis/archives/Omron SS-5GL2.sldprt
CAO/X_V2-axis/archives/Plate Gripper - oldversion.STEP
CAO/X_V2-axis/archives/Plate Gripper - oldversion.sldprt
CAO/X_V2-axis/archives/Screw M5 35 mm.STEP
CAO/X_V2-axis/archives/Screw M5 35 mm.sldprt
CAO/Z_V2-axis/2GT_timer.SLDPRT
CAO/Z_V2-axis/Bracket.SLDPRT
CAO/Z_V2-axis/Bracket.STL
CAO/Z_V2-axis/Plate_Z_bottom_V2.sldprt
CAO/Z_V2-axis/Plate_Z_top_V2.sldprt
CAO/Z_V2-axis/Shaft 8 mm 150 mm.sldprt
CAO/Z_V2-axis/Shaft 8 mm 300 mm.sldprt
CAO/Z_V2-axis/Stepper Nema 17.sldprt
CAO/Z_V2-axis/archives/M1233032.SLDASM
CAO/Z_V2-axis/archives/Plaque_dessus_profil_V1.STEP
CAO/Z_V2-axis/archives/Plaque_dessus_profil_V1.sldprt
CAO/Z_V2-axis/archives/Plate Z-axis Bottom.STEP
CAO/Z_V2-axis/archives/Plate Z-axis Bottom.sldprt
CAO/Z_V2-axis/archives/fixation moteur.SLDPRT
CAO/Z_V2-axis/archives/fixation moteur.STEP
CAO/Z_V2-axis/archives/équerre.SLDPRT
CAO/Z_V2-axis/archives/équerre.STEP
CAO/Z_V2-axis/archives/équerre2.SLDPRT
CAO/Z_V2-axis/archives/équerre2.STEP
CAO/Z_V2-axis/belt clamp.SLDPRT
CAO/Z_V2-axis/belt clamp.STL
CAO/Z_V2-axis/montage_courroie_profil.SLDASM
CAO/belt_system_V2.SLDASM
CAO/ungrip_rover/Camera Box Bottom.sldprt
CAO/ungrip_rover/Camera Box Bottom.stl
CAO/ungrip_rover/Camera Box Top.STL
CAO/ungrip_rover/Camera Box Top.sldprt
CAO/ungrip_rover/Frame.SLDPRT
CAO/ungrip_rover/Motor Bracket.sldprt
CAO/ungrip_rover/Motor Pololu 131_1.sldprt
CAO/ungrip_rover/Screw Hub.STEP
CAO/ungrip_rover/Screw Hub.sldprt
CAO/ungrip_rover/Shaft Support 8 mm flat.sldprt
CAO/ungrip_rover/Wheel.sldprt
CAO/ungrip_rover/support batterie.SLDPRT
CAO/ungrip_rover/support batterie.STL
CAO/ungrip_rover/ungrip_rover.sldasm
