Nicobranas/RoDeP-documentation/docs/assembly.md

## Preparing your components

<p align = justify>Before assembling the RoDeP, be sure having all the required components, they are enumerated in the </p>[component list](component.md).

## 1. Assembling the frame
<p align = justify> In order to assemble the frame, you have to gather the following elements :
<br/> </p>

|Number|Component|
|---|---|
|1|frame|
|2|wheel|
|2|wheel motor|
|2|roulette|
|2|battery wedge|

<p align = justify> In the end, you should have something like this :
<br/> </p>

Frame RoDep

## 2. Assembling the gripping part
<p align = justify> In order to assemble the frame, you have to gather the elements found in the gripping part of the gripper page : <br/> </p>
[component list](gripp.md).

<p align = justify>Once you are ready, the assembling process is simple, and once it is done, the gripping part should be like this :<br/></p>
Gripping system picture 1
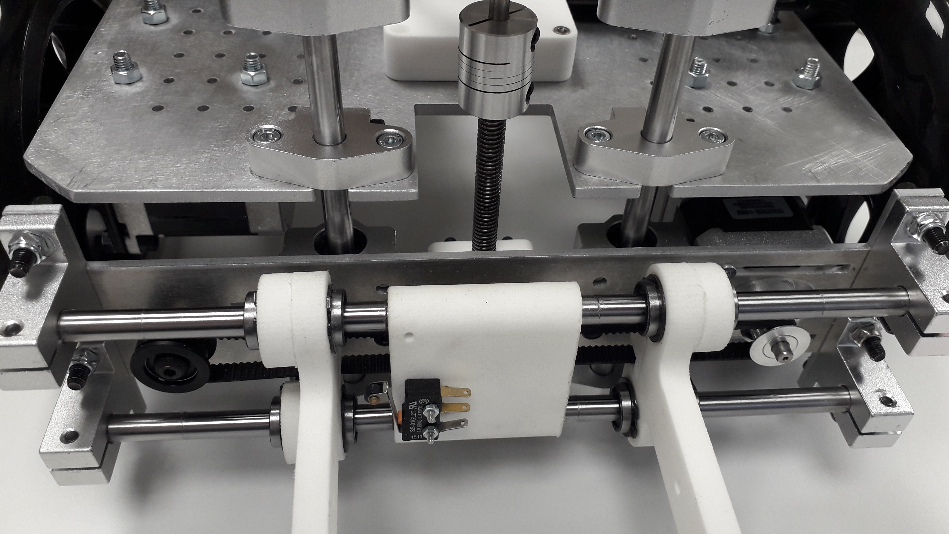
[picture p54: docs/Gripp files/Gripp_zoom2.JPG]
Gripping system picture 2

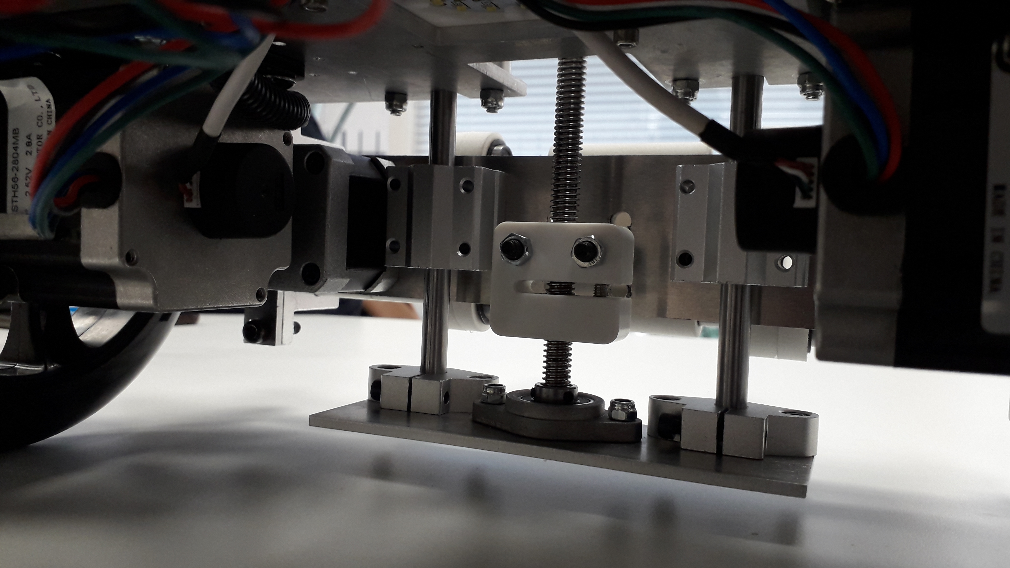
[picture p55: docs/Gripp files/Gripp_zoom3.JPG]
Gripping system picture 3

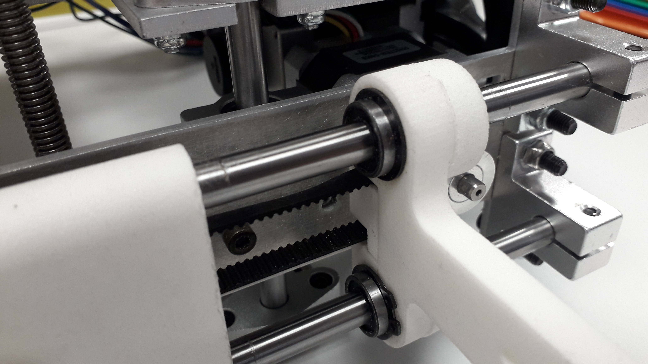
[picture p56: docs/Gripp files/Gripp_zoom4.JPG]

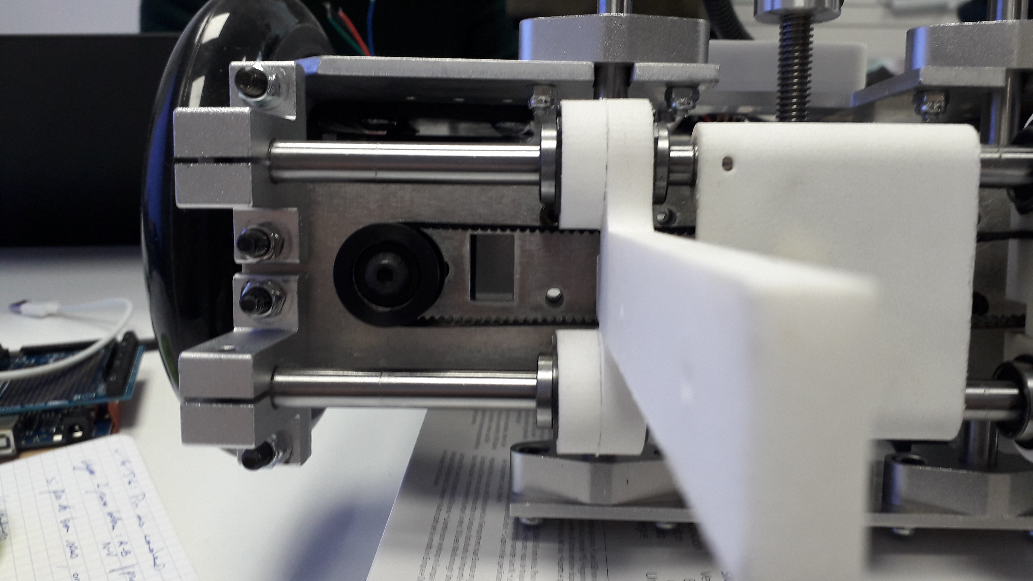
[picture p57: docs/Gripp files/Gripp_zoom5.JPG]


## 3. Assembling the elevation system
<p align = justify> In order to assemble the final part of the RoDeP, you have to gather the elements found in the second part of the gripper components :
<br/> </p>
Elevation system picture 1
Elevation system picture 2
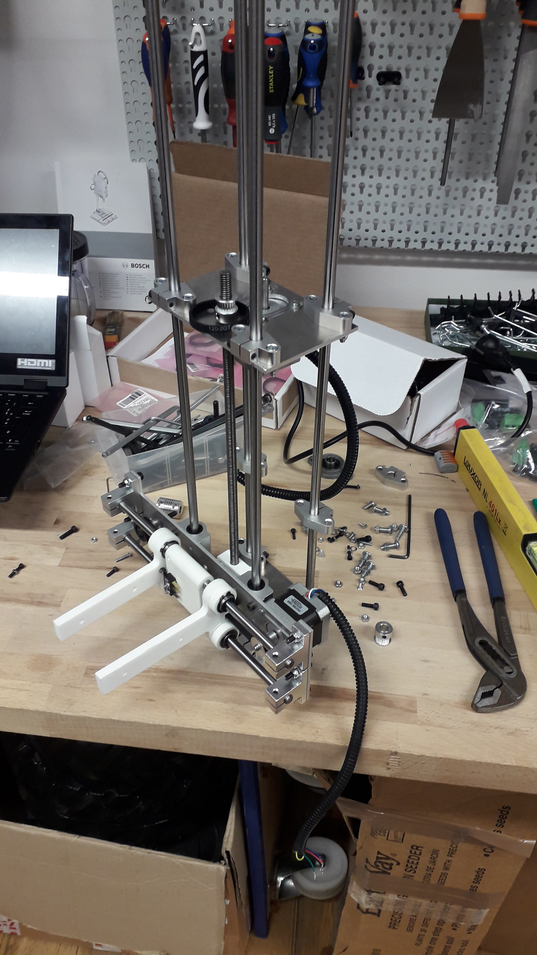
[picture p58: docs/Gripp files/Elevation_zoom3.JPG]
Elevation system picture 3

Elevation system picture 4
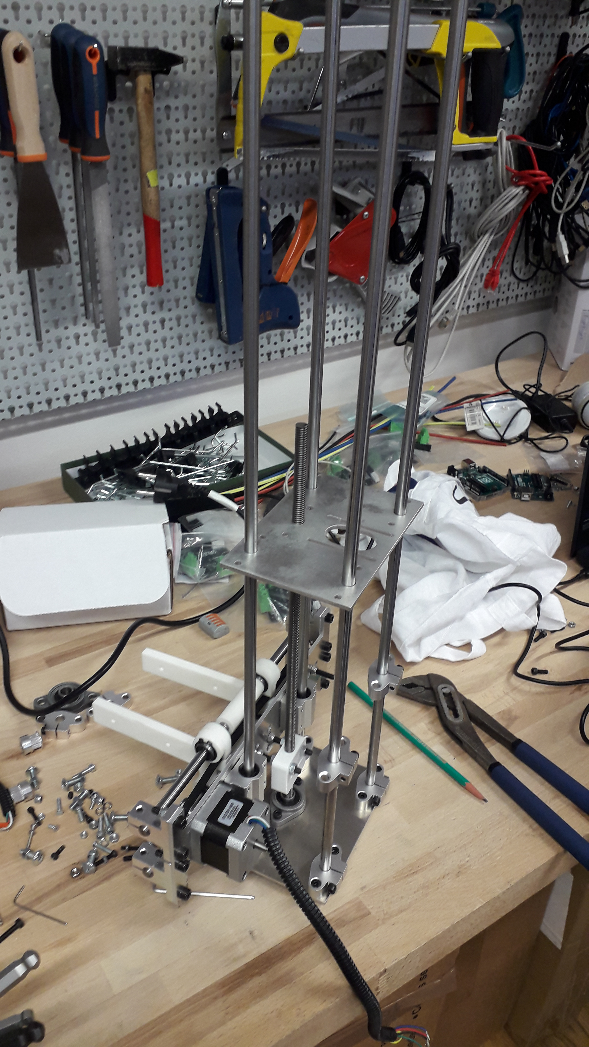
[picture p59: docs/Gripp files/Elevation_zoom5.JPG]
Elevation system picture 4

Elevation system picture 4

<p align = justify> Once this is done, the physical form of the RoDeP should be finished, now is the time for getting the code work !<br/></p>
[The code](software.md)
