Nicobranas/RoDeP-documentation/docs/starting_instruction.md

#Starting Instructions

<p align = justify>In order to see a working robot, you will need to follow those steps.  <br/> </p>

## 1 : Building the robot

<p align = justify>Building the robot is the first step to ensure the development of the project.  <br/> </p>

## 2 : Coding

<p align = justify>Now is the time to add the code to the robot, so it would follow the line and take the plants.  <br/> </p>

## 3 : Testing the robot

<p align = justify>If everything is ready, now all you need is to try the robot ! <br/> </p>
