Nicobranas/RoDeP-documentation/docs/Building files/blue_line.png

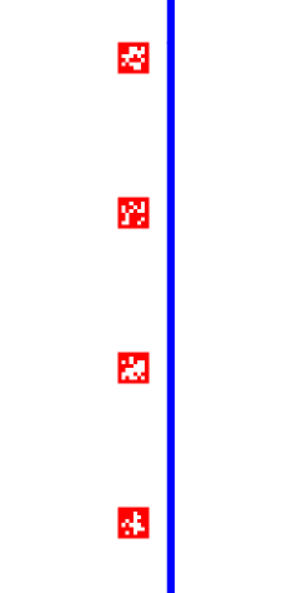
docs/Building files/blue_line.png
