Nicobranas/RoDeP-documentation/docs/Building files/green_line.png

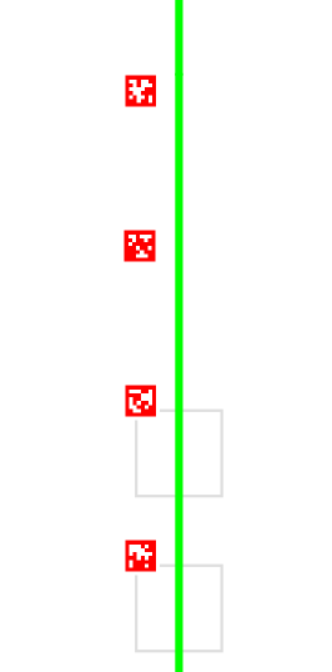
docs/Building files/green_line.png
