Nicobranas/RoDeP-documentation/site/Building files/rodep_v0_1.JPG

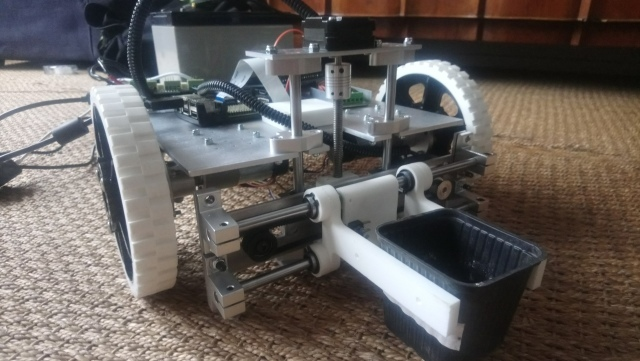
site/Building files/rodep_v0_1.JPG
