Nicobranas/RoDeP-documentation/site/Building files/rodep_v0_2.JPG

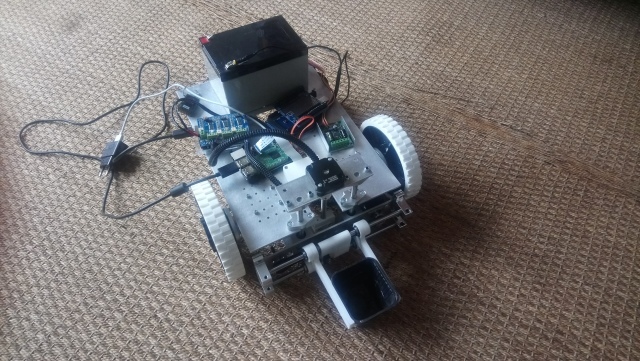
site/Building files/rodep_v0_2.JPG
