Nicobranas/RoDeP-documentation/site/Building files/rodep_v1.png

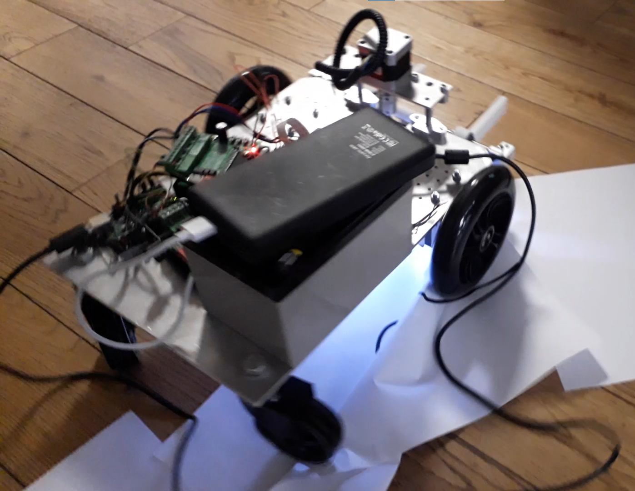
site/Building files/rodep_v1.png
