Nicobranas/RoDeP-documentation/(list of files, drawings)

Other design files:
docs/Electronic files/RoDeP-elec.fzz
site/Electronic files/debut conception.fzz
