Nicobranas/RoDeP-documentation/(commit log)

2021-05-25 add fritzing
    [debut conception.fzz]
2021-05-25 starting shopping list for gripper
2021-05-25 ajout de pages
    [debut conception.fzz]
2021-06-15 imported Paul documentation
    [debut conception.fzz]
2021-07-28 add CAO
    [2GT_timer.SLDPRT, 2GT_timer.STEP, Belt Tightner.STEP, Belt Tightner.sldprt, Camera Box Bottom.STEP, Camera Box Bottom.sldprt, Camera Box Top.STEP, Camera Box Top.sldprt]
2021-07-29 CAO and doc update
    [Plaque_dessus_profil.STEP, Plaque_dessus_profil.sldprt, debut conception.fzz, equerre3.SLDPRT, equerre3.STEP, montage_courroie_profil.SLDASM, pince_courroie.SLDPRT, ungrip_rover.sldasm]
2021-07-30 electrical diagram
    [RoDeP-elec.fzz, debut conception.fzz]
